EOLab-HSRW/dronebridge-radio/images/closeup-radio.jpg

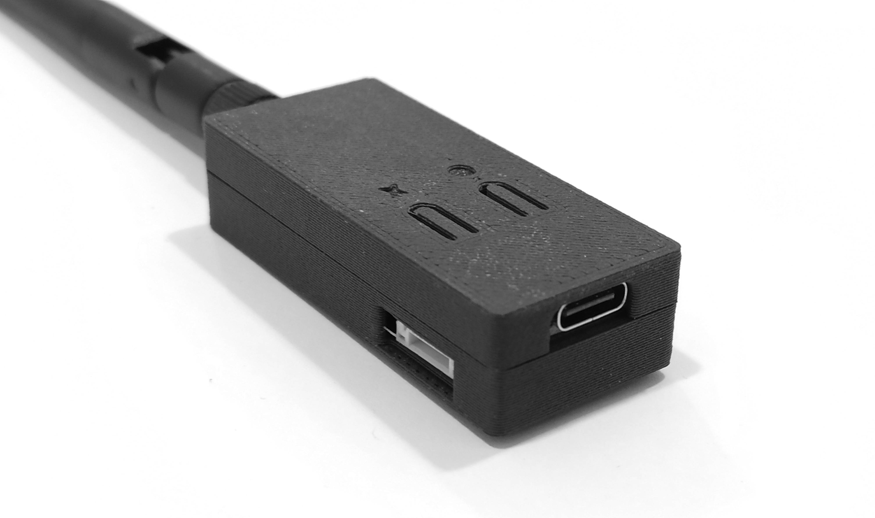
images/closeup-radio.jpg
