EOLab-HSRW/dronebridge-radio/3d-printed-parts/housing-button.3mf

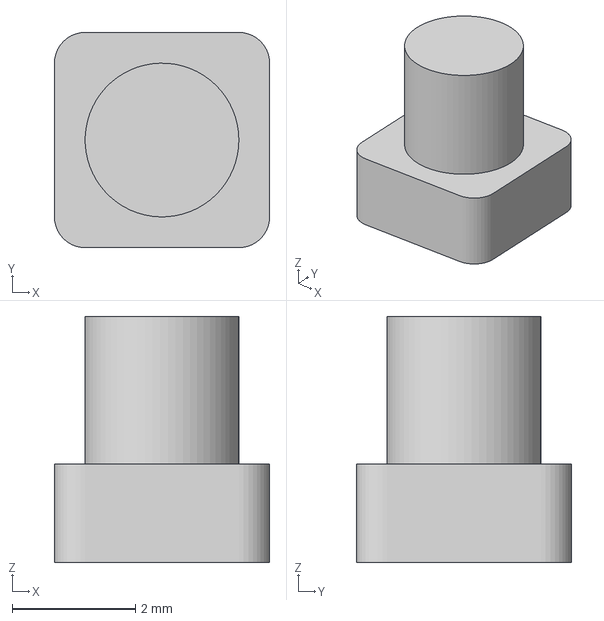
[picture p5: CAD file, 2026-03-13]
3d-printed-parts/housing-button.3mf
3.50 x 3.50 x 4.00 mm
