EOLab-HSRW/dronebridge-radio/dronebridge-radio.step

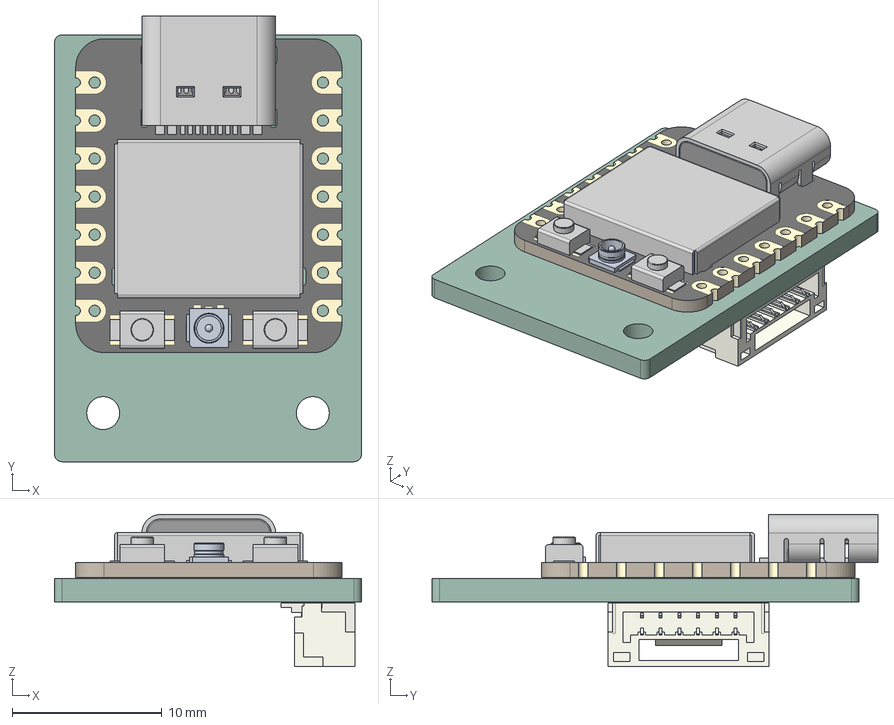
[picture p6: CAD file, 2025-03-23]
dronebridge-radio.step
20.5 x 29.7 x 10.2 mm
Seeed Studio XIAO-ESP32-C3 v15
JST_SM06B_GHS_TB
dronebridge-radio_PCB
