EOLab-HSRW/dronebridge-radio/3d-printed-parts/housing-base.3mf

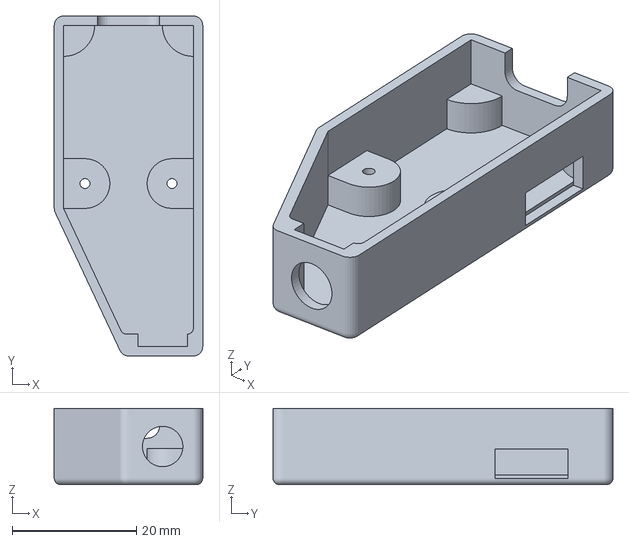
[picture p7: CAD file, 2026-03-13]
3d-printed-parts/housing-base.3mf
23.9 x 54.7 x 12.2 mm
