EOLab-HSRW/dronebridge-radio/3d-printed-parts/housing-top-cover.3mf

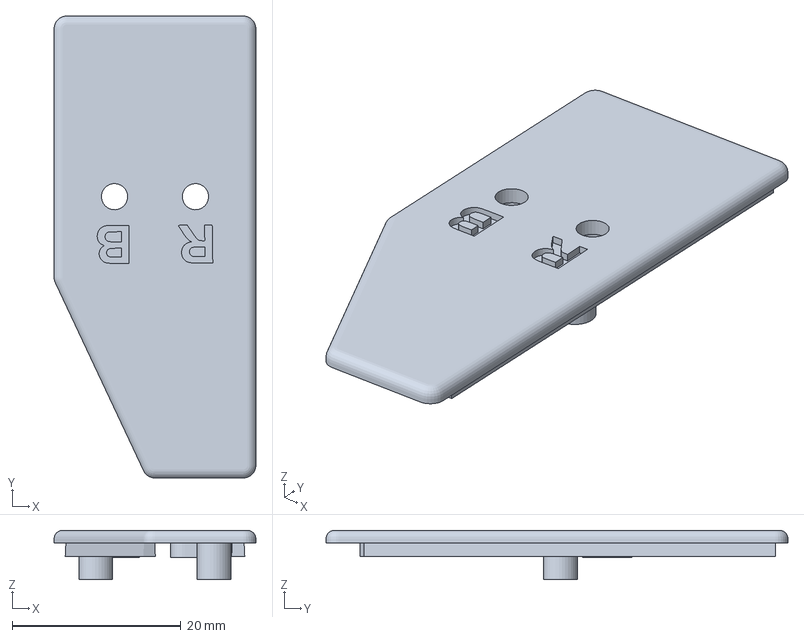
[picture p8: CAD file, 2026-03-13]
3d-printed-parts/housing-top-cover.3mf
23.9 x 54.7 x 5.84 mm
