EOLab-HSRW/dronebridge-radio/dronebridge-radio/dronebridge-radio.kicad_sch

## KiCad design dronebridge-radio/dronebridge-radio.kicad_sch (2026-01-25)

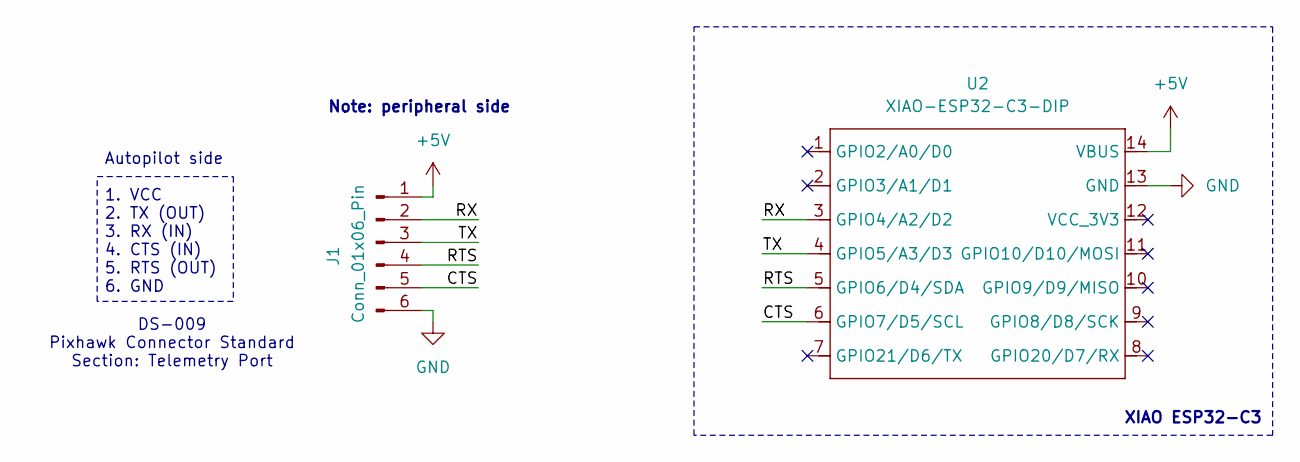
[picture p9: schematic dronebridge-radio.kicad_sch]

Parts:
J1: Conn_01x06_Pin; JST_GH_SM06B-GHS-TB_1x06-1MP_P1.25mm_Horizontal; Digikey 455-1568-2-ND
U2: XIAO-ESP32-C3-DIP; XIAO-ESP32C3-DIP; Digikey 1597-113991054-ND

Connections:
+5V: J1.1, U2.14 (VBUS)
CTS: J1.5, U2.6 (GPIO7/D5/SCL)
GND: J1.6, U2.13 (GND)
RTS: J1.4, U2.5 (GPIO6/D4/SDA)
RX: J1.2, U2.3 (GPIO4/A2/D2)
TX: J1.3, U2.4 (GPIO5/A3/D3)

Notes on the sheet:
DS-009 Pixhawk Connector Standard Section: Telemetry Port
XIAO ESP32-C3
Note: peripheral side
Autopilot side 1. VCC 2. TX (OUT) 3. RX (IN) 4. CTS (IN) 5. RTS (OUT) 6. GND
