EOLab-HSRW/dronebridge-radio/MAKEME.md

# How to Make the Radio

<table align="center" width="70%">
  <tr>
    <td align="center">
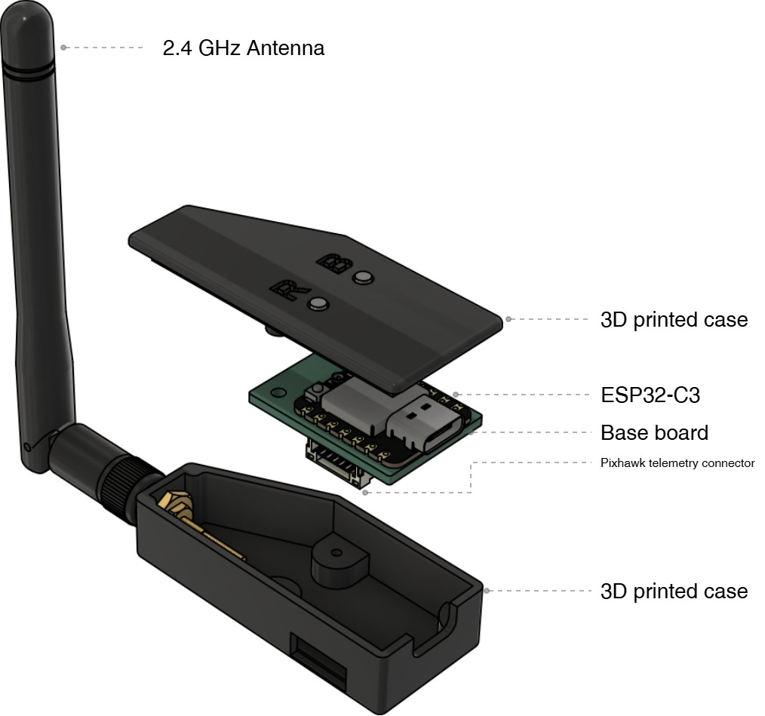
[picture p10: images/components.jpg]
Components
      
      <p style="margin:8px 0 0;  text-align:center;">The set of components that compose the radio.</p>
    </td>
  </tr>
</table>

| Item | Quantity | Description |
|---|---|---|
| [XIAO ESP32-C3](https://www.seeedstudio.com/seeed-xiao-esp32c3-p-5431.html) | 1 | |
| Base board (simple-custom PCB) | 1 | The base board is a simple PCB that routes the traces from the XIAO to the telemetry connector. It also serves as a mechanical structure that the 3D-printed case attaches to. You can find the files under [DroneBridge Radio - KiCAD files](./dronebridge-radio). |
| Antenna | 1 | Depending on the application we use two types of antennas.<br/><br/>"Air units": Are telemetry radios mounted in the drones, we use the *Manufacturer Product Number* [553-1471-ND - Digikey](https://www.digikey.de/de/products/detail/pulse-electronics/W1010/1616689).<br/>- Frequency: 2.4 GHz<br/>- Antenna Type: Whip, Tilt<br/>- Gain: 2dBi<br/>- Termination: SMA Male<br/><br/>"Ground units": Normally use in ground radios, we use the *Manufacturer Product Number* [RST-W2A1-195013-22M-GE-001 - Digikey](https://www.digikey.de/en/products/detail/raltron-electronics/RST-W2A1-195013-22M-GE-001/16686283)<br/>- Frequency: 2.4 GHz<br/>- Antenna Type: Whip, Tilt<br/>- Gain: 5dBi<br/>- Termination: SMA Male |
| Antenna cable | 1 | *Manufacturer Product Number* [336313-12-0050 - Digikey](https://www.digikey.de/en/products/detail/amphenol-rf/336313-12-0050/5417985).<br/>- Style: U.FL (UMCC), AMC to SMA<br/>- Length: 1.969" (50.00mm) |

Extras:
  - If you want to create your own case: [3D model (PCB)](./dronebridge-radio.step).
  - [Gerber files](./dronebridge-radio/production/dronebridge-radio.zip).
  - If you want to uder the board use: [Production files](./dronebridge-radio/production), 
  - [Bill Of Materials (BOM - PCB only)](./dronebridge-radio/production/bom.csv)
