EOLab-HSRW/dronebridge-radio/(commit log)

2025-03-23 init project
    [dronebridge-radio.kicad_pcb, dronebridge-radio.kicad_sch]
2025-03-23 add production files
    [dronebridge-radio.step]
2025-05-18 fix silk-screen labels
    [dronebridge-radio.kicad_pcb]
2025-05-20 update production files to reflex fix on silkscreen labels
2026-03-13 fix swap reset and boot labels on the board
    [dronebridge-radio.kicad_pcb]
2026-03-13 add 3d model for printing housing
    [housing-base.3mf, housing-button.3mf, housing-top-cover.3mf]
